Cipulot/Copre/README.md

# Copre
 40% Topre you can do whatever you want with.
