Cipulot/Copre/Assets/PCB_render_back.png

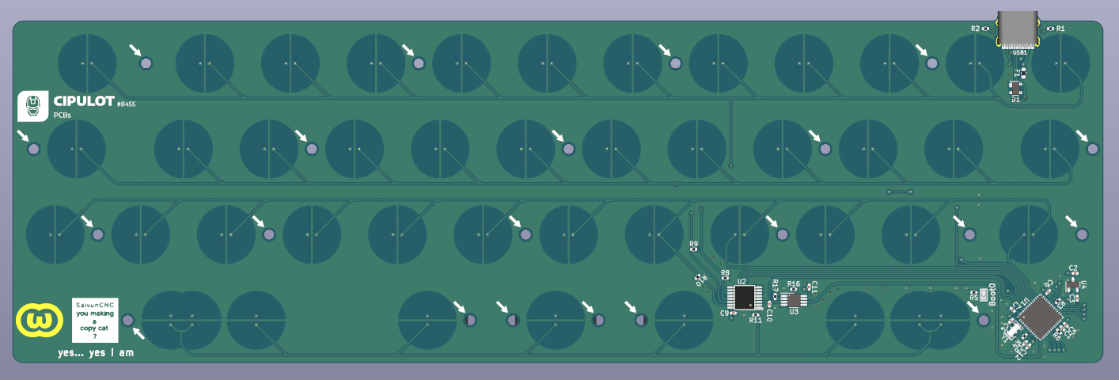
Assets/PCB_render_back.png
