Cipulot/Copre/Assets/PCB_render_front.png

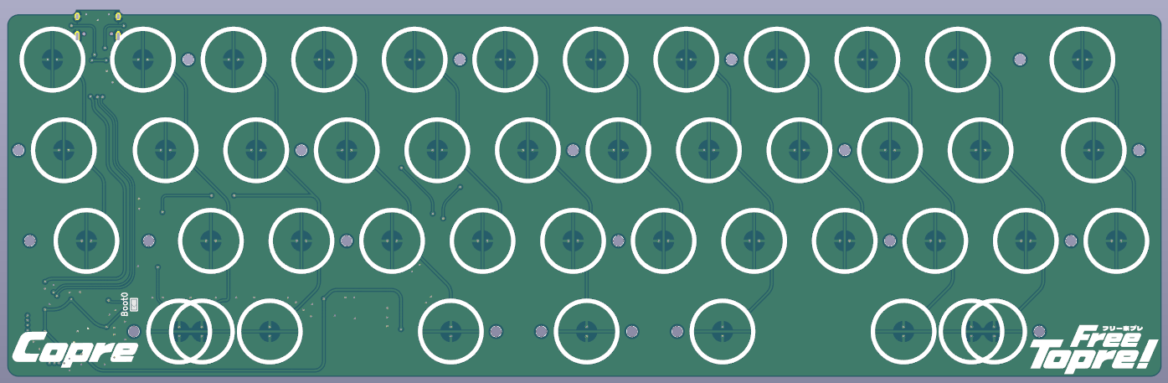
Assets/PCB_render_front.png
