Cipulot/Copre/Assets/Copre.step

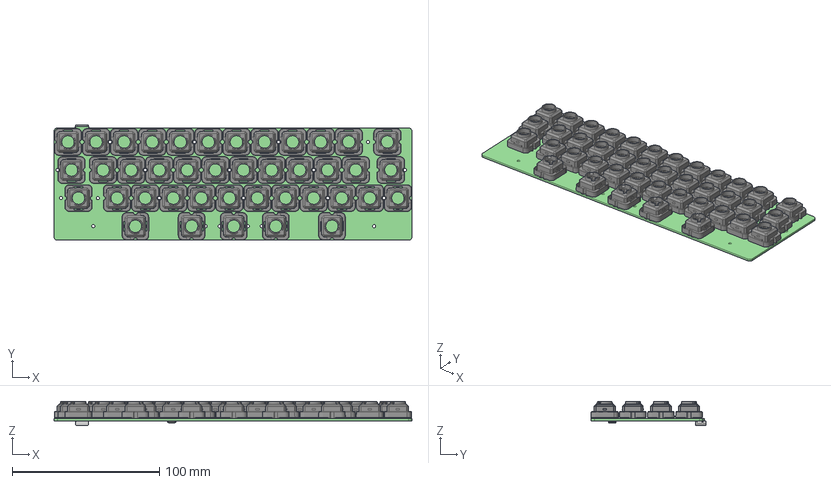
[picture p3: CAD file, 2022-10-09]
Assets/Copre.step
242.9 x 78.3 x 16.6 mm
Copre PCB
