Cipulot/Copre/PCB/Copre.kicad_pcb

## KiCad design PCB/Copre.kicad_pcb (2022-10-09)

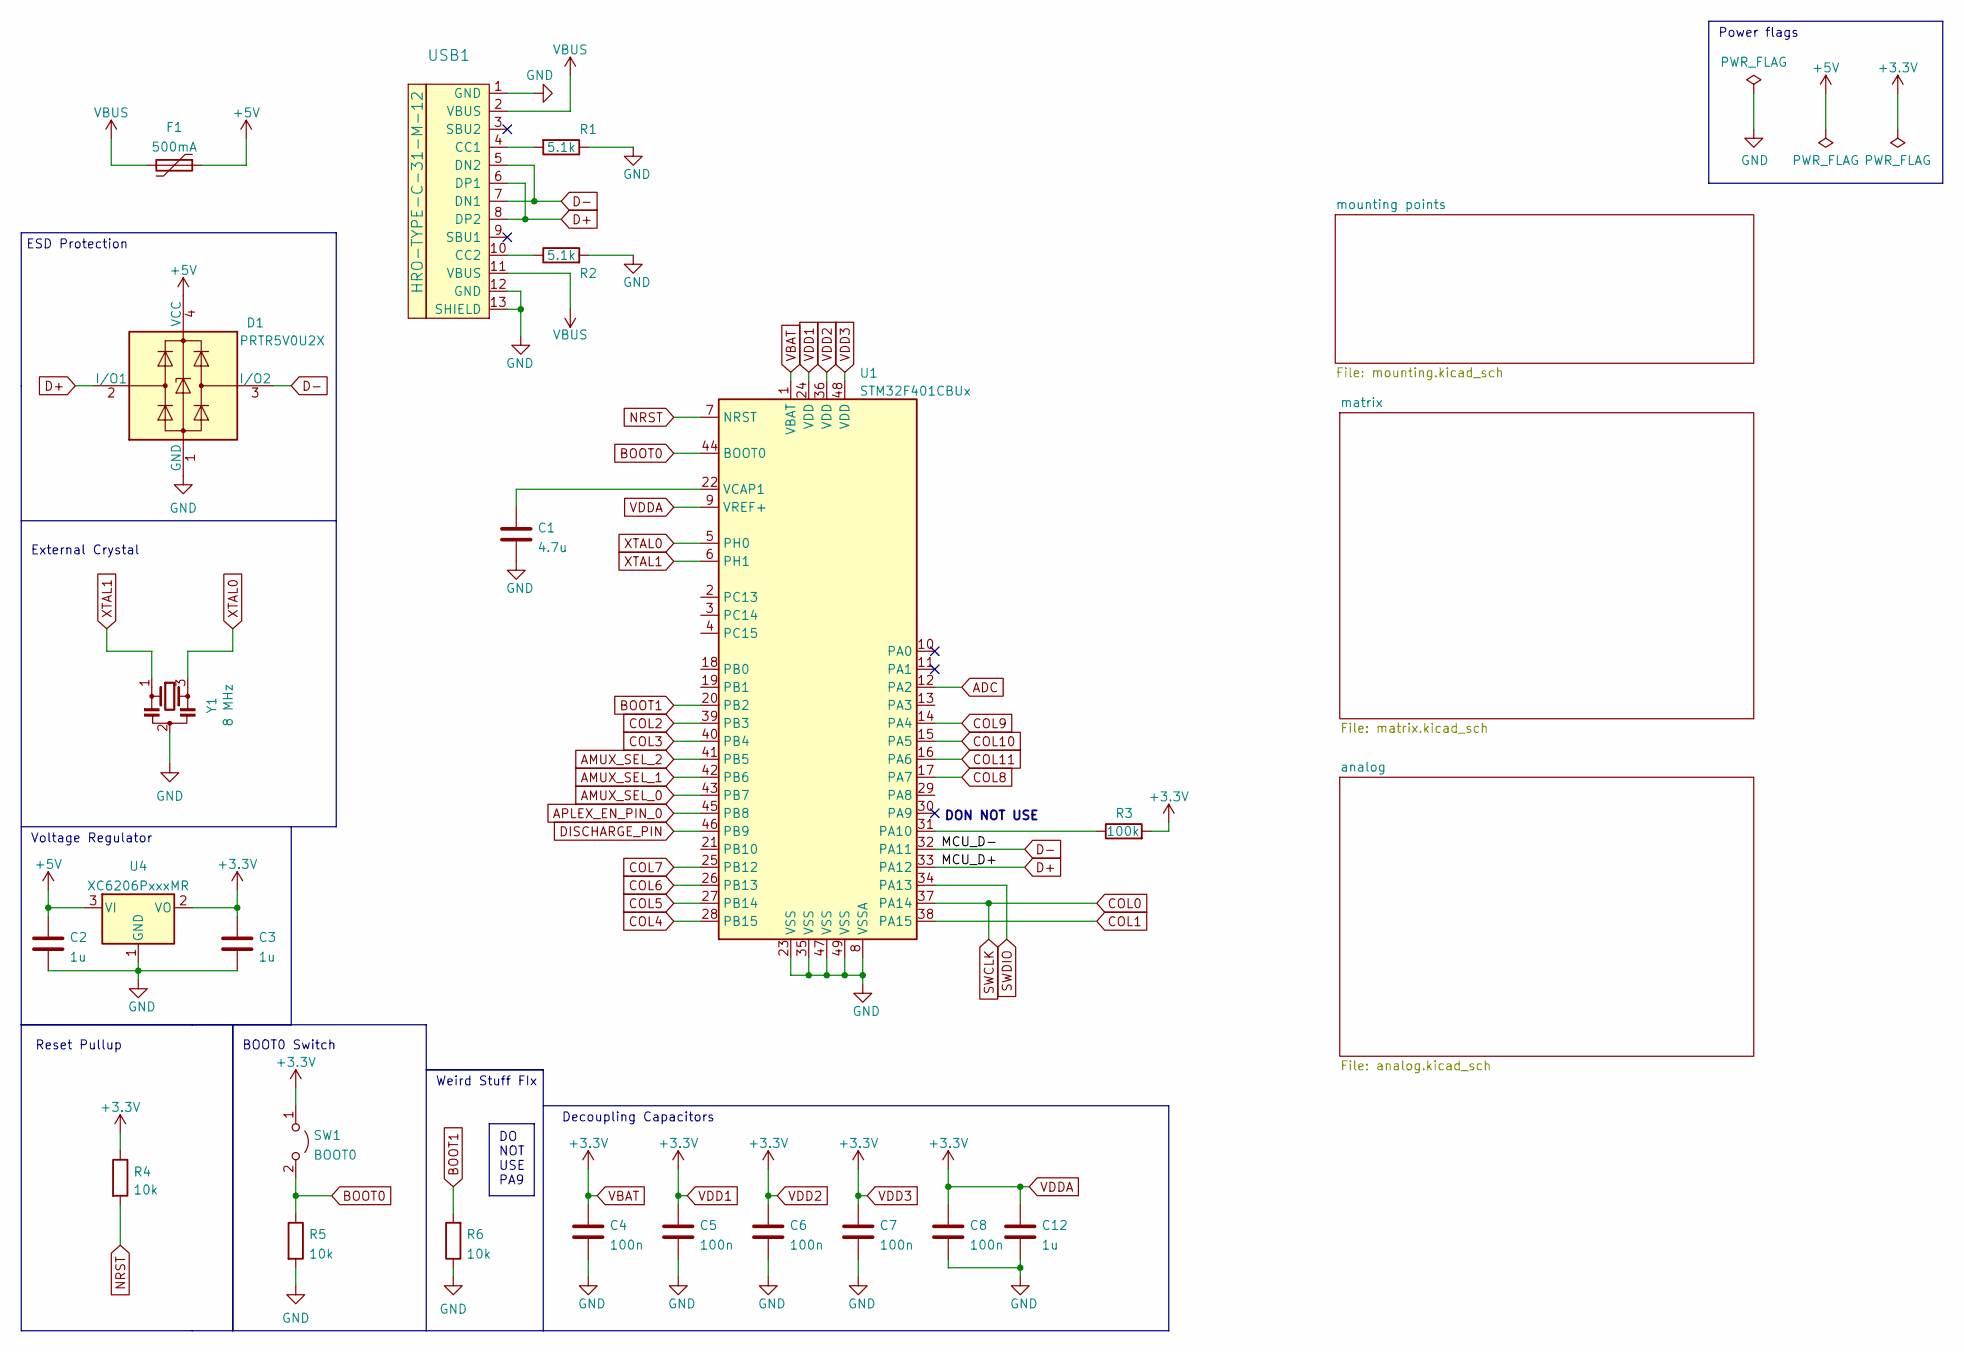
[picture p4: schematic Copre.kicad_sch]

Parts:
C1: 4.7u; C_0402_1005Metric; LCSC C23733
C2, C3, C12: 1u; C_0402_1005Metric; LCSC C52923
C4, C5, C6, C7, C8: 100n; C_0402_1005Metric; LCSC C307331
D1: PRTR5V0U2X; SOT-143; LCSC C2827688
F1: 500mA; Fuse_0603_1608Metric; LCSC C720073
R1, R2: 5.1k; R_0402_1005Metric; LCSC C25905
R3: 100k; R_0402_1005Metric; LCSC C25741
R4, R5, R6: 10k; R_0402_1005Metric; LCSC C25744
SW1: BOOT0; JUMPER_SMD_2DUB
U1: STM32F401CBUx; QFN-48-1EP_7x7mm_P0.5mm_EP5.6x5.6mm; LCSC C118825
U4: XC6206PxxxMR; SOT-23; LCSC C5446
USB1: HRO-TYPE-C-31-M-12; HRO-TYPE-C-31-M-12-Assembly
Y1: 8 MHz; Resonator_SMD_Murata_CSTxExxV-3Pin_3.0x1.1mm; LCSC C907975

Connections:
+5V: C2.1, D1.4 (VCC), F1.1, U4.3 (VI)
ADC: U1.12 (PA2); also elsewhere on the board
AMUX_SEL_0: U1.43 (PB7); also elsewhere on the board
AMUX_SEL_1: U1.42 (PB6); also elsewhere on the board
AMUX_SEL_2: U1.41 (PB5); also elsewhere on the board
APLEX_EN_PIN_0: U1.45 (PB8); also elsewhere on the board
APLEX_OUT_PIN_0: U1.46 (PB9); also elsewhere on the board
BOOT0: R5.1, SW1.2 (B), U1.44 (BOOT0)
BOOT1: R6.2, U1.20 (PB2)
COL0: U1.37 (PA14); also elsewhere on the board
COL1: U1.38 (PA15); also elsewhere on the board
COL2: U1.39 (PB3); also elsewhere on the board
COL3: U1.40 (PB4); also elsewhere on the board
COL4: U1.28 (PB15); also elsewhere on the board
COL5: U1.27 (PB14); also elsewhere on the board
COL6: U1.26 (PB13); also elsewhere on the board
COL7: U1.25 (PB12); also elsewhere on the board
COL8: U1.17 (PA7); also elsewhere on the board
COL9: U1.14 (PA4); also elsewhere on the board
COL10: U1.15 (PA5); also elsewhere on the board
COL11: U1.16 (PA6); also elsewhere on the board
D+: D1.2 (I/O1), U1.33 (PA12), USB1.6 (DP1), USB1.8 (DP2)
D-: D1.3 (I/O2), U1.32 (PA11), USB1.5 (DN2), USB1.7 (DN1)
GND: C1.2, C2.2, C3.2, C4.2, C5.2, C6.2, C7.2, C8.2, C12.2, D1.1 (GND), R1.1, R2.2, R5.2, R6.1, U1.8 (VSSA), U1.23 (VSS), U1.35 (VSS), U1.47 (VSS), U1.49 (VSS), U4.1 (GND), USB1.1 (GND), USB1.12 (GND), USB1.13 (SHIELD), Y1.2; also elsewhere on the board
NRST: R4.2, U1.7 (NRST)
unnamed: C1.1, U1.22 (VCAP1)
unnamed: R1.2, USB1.4 (CC1)
unnamed: R2.1, USB1.10 (CC2)
unnamed: R3.1, U1.31 (PA10)
SWDIO: U1.34 (PA13)
VBAT: C3.1, C4.1, C5.1, C6.1, C7.1, C8.1, C12.1, R3.2, R4.1, SW1.1 (A), U1.1 (VBAT), U1.9 (VREF+), U1.24 (VDD), U1.36 (VDD), U1.48 (VDD), U4.2 (VO); also elsewhere on the board
VBUS: F1.2, USB1.2 (VBUS), USB1.11 (VBUS)
XTAL0: U1.5 (PH0), Y1.3
XTAL1: U1.6 (PH1), Y1.1

Notes on the sheet:
DO NOT USE PA9
Voltage Regulator
DON NOT USE
BOOT0 Switch
External Crystal
Weird Stuff FIx
Decoupling Capacitors
Power flags
ESD Protection
Reset Pullup

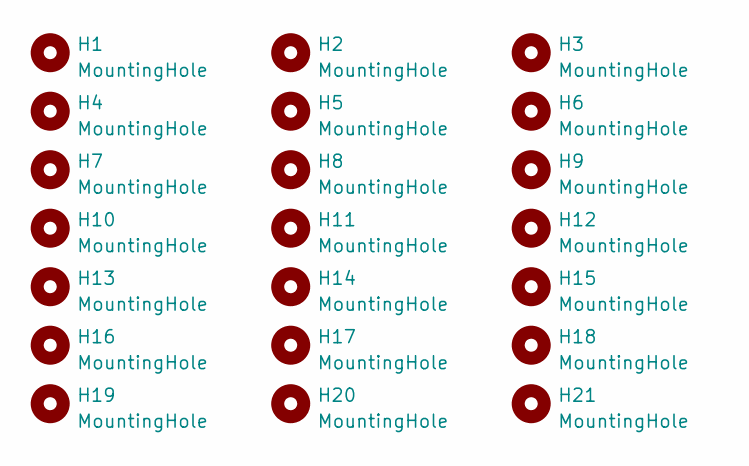
[picture p5: schematic mounting.kicad_sch, Copre]

Parts:
H1, H2, H3, H4, H5, H6, H7, H8, H9, H10, H11, H12, H13, H14, H15, H16, H17, H18, H19, H20, H21: MountingHole; HOLE_M2

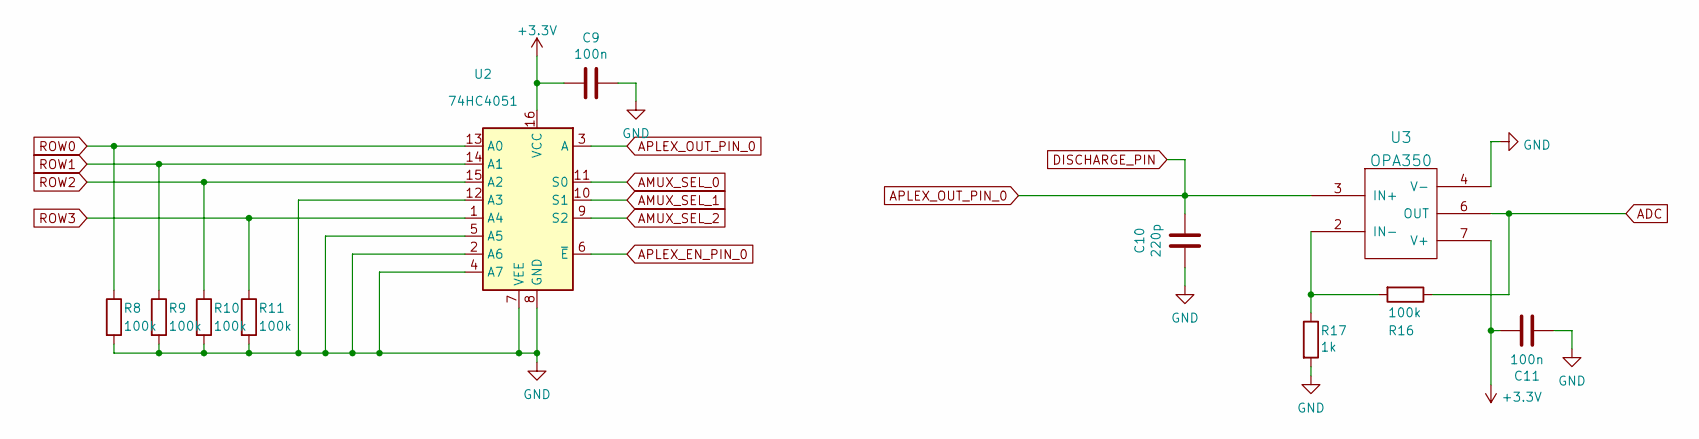
[picture p6: schematic analog.kicad_sch, Copre]

Parts:
C9, C11: 100n; C_0402_1005Metric; LCSC C307331
C10: 220p; C_0402_1005Metric; LCSC C1530
R8, R9, R10, R11, R16: 100k; R_0402_1005Metric; LCSC C25741
R17: 1k; R_0402_1005Metric; LCSC C11702
U2: 74HC4051; TSSOP16; LCSC C5645
U3: OPA350; VSSOP-8_3.0x3.0mm_P0.65mm; LCSC C87906

Connections:
ADC: R16.1, U3.6 (OUT); also elsewhere on the board
AMUX_SEL_0: U2.11 (S0); also elsewhere on the board
AMUX_SEL_1: U2.10 (S1); also elsewhere on the board
AMUX_SEL_2: U2.9 (S2); also elsewhere on the board
APLEX_EN_PIN_0: U2.6 (~E); also elsewhere on the board
APLEX_OUT_PIN_0: C10.1, U2.3 (A), U3.3 (IN+); also elsewhere on the board
GND: C9.1, C10.2, C11.1, R8.2, R9.2, R10.2, R11.2, R17.2, U2.2 (A6), U2.4 (A7), U2.5 (A5), U2.7 (VEE), U2.8 (GND), U2.12 (A3), U3.4 (V-); also elsewhere on the board
unnamed: R16.2, R17.1, U3.2 (IN-)
ROW0: R8.1, U2.13 (A0); also elsewhere on the board
ROW1: R9.1, U2.14 (A1); also elsewhere on the board
ROW2: R10.1, U2.15 (A2); also elsewhere on the board
ROW3: R11.1, U2.1 (A4); also elsewhere on the board
VBAT: C9.2, C11.2, U2.16 (VCC), U3.7 (V+); also elsewhere on the board

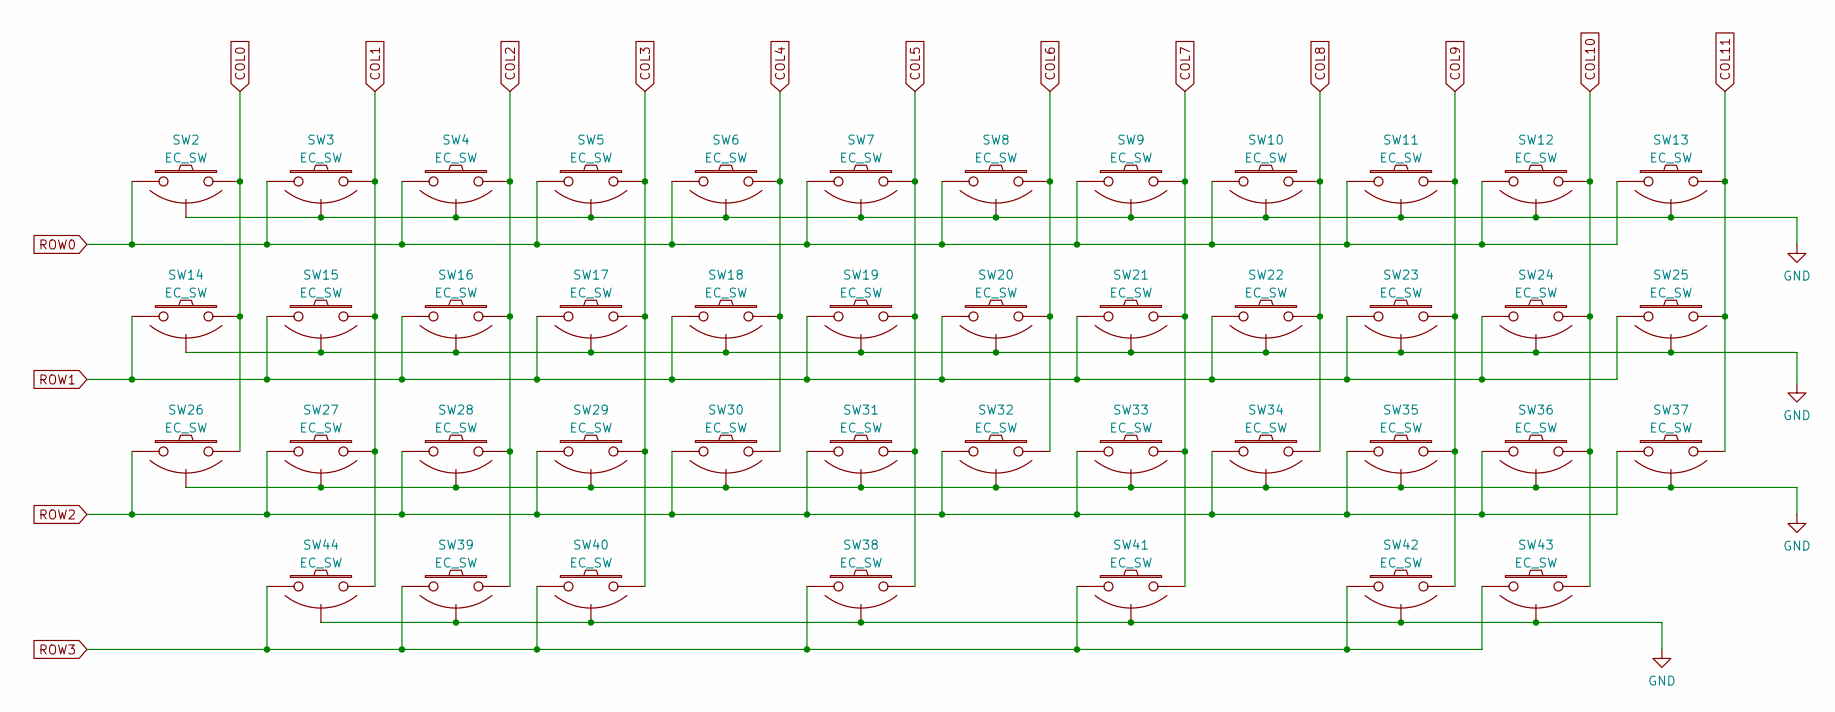
[picture p7: schematic matrix.kicad_sch, Copre]

Parts:
SW2, SW3, SW4, SW5, SW6, SW7, SW8, SW9, SW10, SW11, SW12, SW13, SW14, SW15, SW16, SW17, SW18, SW19, SW20, SW21, SW22, SW23, SW24, SW25, SW26, SW27, SW28, SW29, SW30, SW31, SW32, SW33, SW34, SW35, SW36, SW37, SW38, SW39, SW40, SW41, SW42: EC_SW; ecs_pad_no_ring
SW43, SW44: EC_SW; ecs_pad_no_ring_stepped&normal

Connections:
COL0: SW2.2, SW14.2, SW26.2; also elsewhere on the board
COL1: SW3.2, SW15.2, SW27.2, SW44.1; also elsewhere on the board
COL2: SW4.2, SW16.2, SW28.2, SW39.2; also elsewhere on the board
COL3: SW5.2, SW17.2, SW29.2, SW40.2; also elsewhere on the board
COL4: SW6.2, SW18.2, SW30.2; also elsewhere on the board
COL5: SW7.2, SW19.2, SW31.2, SW38.2; also elsewhere on the board
COL6: SW8.2, SW20.2, SW32.2; also elsewhere on the board
COL7: SW9.2, SW21.2, SW33.2, SW41.2; also elsewhere on the board
COL8: SW10.2, SW22.2, SW34.2; also elsewhere on the board
COL9: SW11.2, SW23.2, SW35.2, SW42.2; also elsewhere on the board
COL10: SW12.2, SW24.2, SW36.2, SW43.1; also elsewhere on the board
COL11: SW13.2, SW25.2, SW37.2; also elsewhere on the board
GND: SW2.3 (SG), SW3.3 (SG), SW4.3 (SG), SW5.3 (SG), SW6.3 (SG), SW7.3 (SG), SW8.3 (SG), SW9.3 (SG), SW10.3 (SG), SW11.3 (SG), SW12.3 (SG), SW13.3 (SG), SW14.3 (SG), SW15.3 (SG), SW16.3 (SG), SW17.3 (SG), SW18.3 (SG), SW19.3 (SG), SW20.3 (SG), SW21.3 (SG), SW22.3 (SG), SW23.3 (SG), SW24.3 (SG), SW25.3 (SG), SW26.3 (SG), SW27.3 (SG), SW28.3 (SG), SW29.3 (SG), SW30.3 (SG), SW31.3 (SG), SW32.3 (SG), SW33.3 (SG), SW34.3 (SG), SW35.3 (SG), SW36.3 (SG), SW37.3 (SG), SW38.3 (SG), SW39.3 (SG), SW40.3 (SG), SW41.3 (SG), SW42.3 (SG), SW43.3 (SG), SW44.3 (SG); also elsewhere on the board
ROW0: SW2.1, SW3.1, SW4.1, SW5.1, SW6.1, SW7.1, SW8.1, SW9.1, SW10.1, SW11.1, SW12.1, SW13.1; also elsewhere on the board
ROW1: SW14.1, SW15.1, SW16.1, SW17.1, SW18.1, SW19.1, SW20.1, SW21.1, SW22.1, SW23.1, SW24.1, SW25.1; also elsewhere on the board
ROW2: SW26.1, SW27.1, SW28.1, SW29.1, SW30.1, SW31.1, SW32.1, SW33.1, SW34.1, SW35.1, SW36.1, SW37.1; also elsewhere on the board
ROW3: SW38.1, SW39.1, SW40.1, SW41.1, SW42.1, SW43.2, SW44.2; also elsewhere on the board

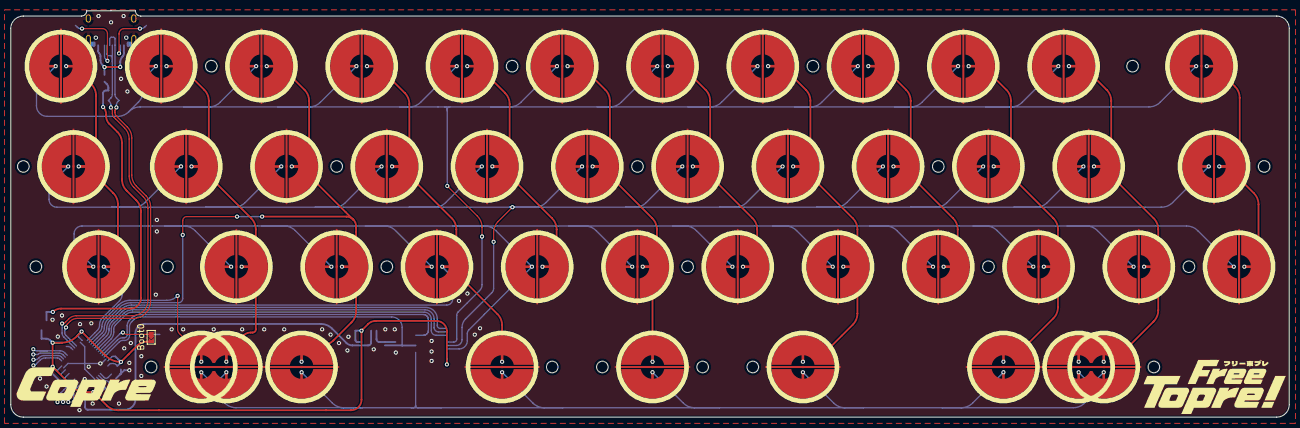
[picture p8: board Copre.kicad_pcb from above]

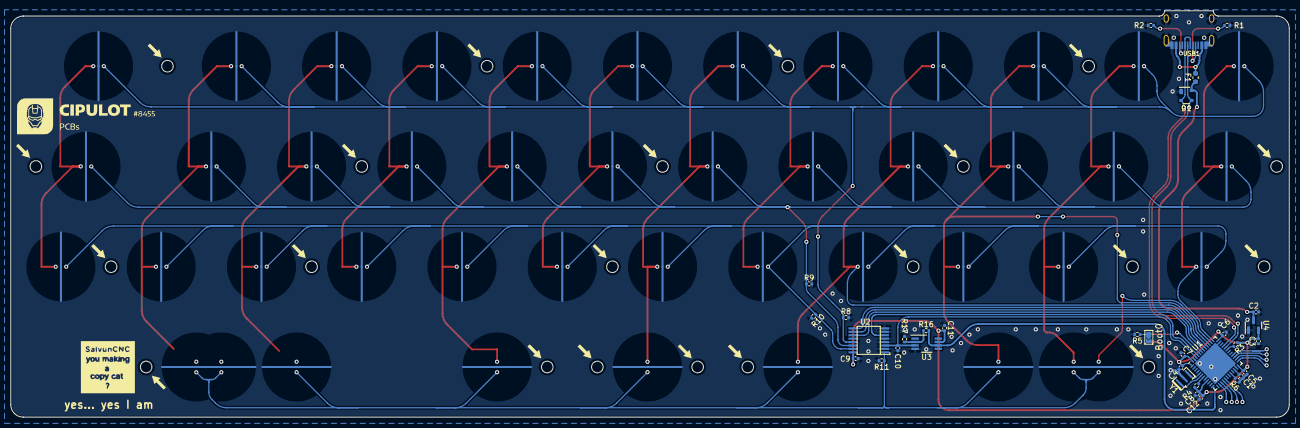
[picture p9: board Copre.kicad_pcb from below]

Board: 4 copper layers, 242.9 x 77.2 mm, 97 parts (32 on the bottom side), 38 nets.
